UCI-Rocket-Project/rocket2-gse-hardware-old/rocket2-gse-hardware.kicad_pcb

## KiCad design rocket2-gse-hardware.kicad_pcb (2024-03-03)

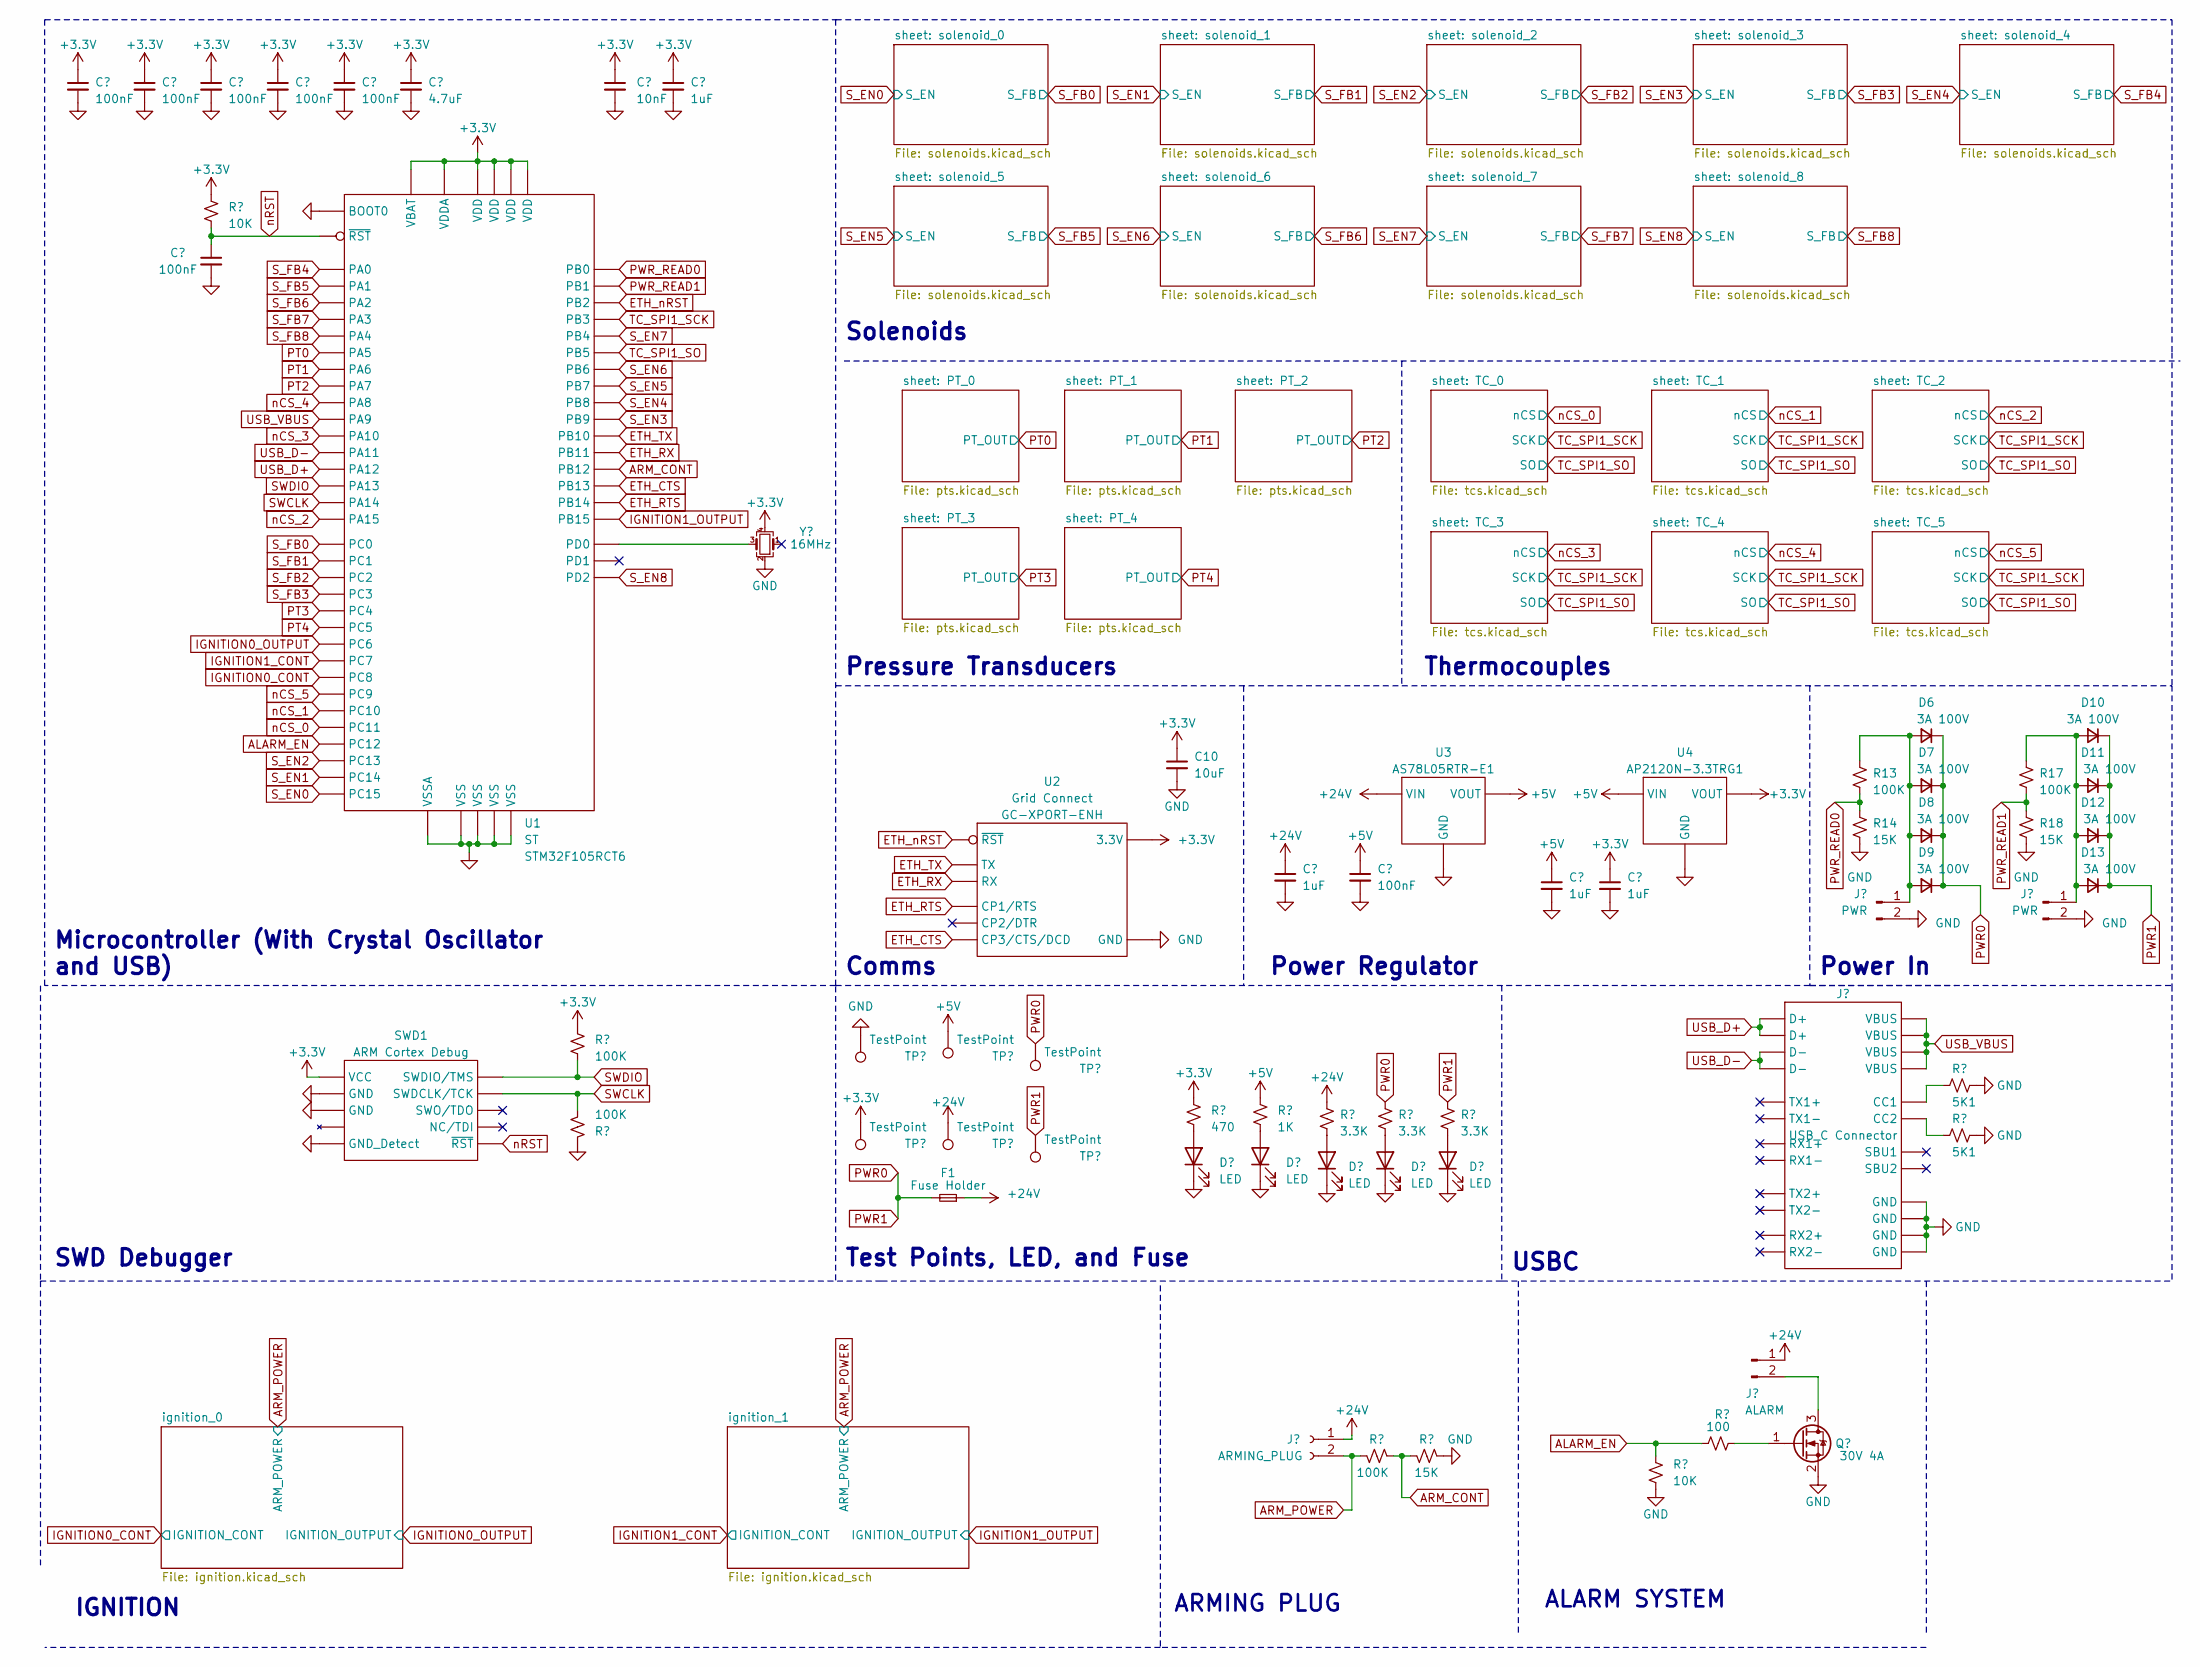
[picture p1: schematic rocket2-gse-hardware.kicad_sch]

Parts:
C1, C2, C3, C4, C5, C6, C12: 100nF; C_0402_1005Metric; Part # Generic 100nF 0402 Capacitor
C7: 4.7uF; C_0402_1005Metric; Part # Generic 4.7uF 0402 Capacitor
C8: 10nF; C_0402_1005Metric; Part # Generic 10nF 0402 Capacitor
C9, C11, C13, C14: 1uF; C_0402_1005Metric; Part # Generic 1uF 0402 Capacitor
C10: 10uF; C_0402_1005Metric; Part # Generic 10uF 0402 Capacitor
D1, D2, D3, D4, D5: LED; LED_0603_1608Metric; Part # Generic 0603 Red LED
D6, D7, D8, D9, D10, D11, D12, D13: 3A 100V; D_SMA; Part # SL310A-TP
F1: Fuse Holder; Fuseholder_Blade_Mini_Keystone_3568; Part # 3568-15
J1: ARMING_PLUG; TerminalBlock_bornier-2_P5.08mm
J2: ALARM; TerminalBlock_bornier-2_P5.08mm
J3: USB_C Connector; USB_C_Receptacle_GCT_USB4105-xx-A_16P_TopMnt_Horizontal; Part # 629105150521
J4, J5: PWR; BarrelJack_Horizontal
Q1: 30V 4A; SOT-23-3; Part # DMG3402L
R1, R11: 10K; R_0402_1005Metric; Part # Generic 10K 1% 0402 Resistor
R2, R3, R7, R13, R17: 100K; R_0402_1005Metric; Part # Generic 100K 1% 0402 Resistor
R4: 470; R_0402_1005Metric; Part # Generic 470 1% 0402 Resistor
R5: 1K; R_0402_1005Metric; Part # Generic 1K 1% 0402 Resistor
R6, R8, R10: 3.3K; R_0402_1005Metric; Part # Generic 3.3K 1% 0402 Resistor
R9, R14, R18: 15K; R_0402_1005Metric; Part # Generic 15K 1% 0402 Resistor
R12: 100; R_0402_1005Metric; Part # Generic 100 1% 0402 Resistor
R15, R16: 5K1; R_0402_1005Metric; Part # Generic 5K1 1% 0402 Resistor
SWD1: ARM Cortex Debug; PinHeader_2x05_P1.27mm_Vertical_SMD; Part # Generic 2x5 1.27mm Connector
TP1, TP2, TP3, TP4, TP5, TP6: TestPoint; TestPoint_Pad_D2.0mm
U1: LQFP-64_10x10mm_P0.5mm; Part # STM32F105RCT6
U2: GC-XPORT; Part # GC-XPORT-ENH
U3: SOT-89-3; Part # AS78L05RTR-E1
U4: SOT-23-3; Part # AP2120N-3.3TRG1
Y1: 16MHz; Crystal_SMD_2016-4Pin_2.0x1.6mm; Part # ECS-1633-160-BN-TR

Connections:
+3.3V: C1.1, C2.1, C3.1, C5.1, C6.1, C7.1, C8.1, C9.1, C10.1, C14.1, R1.1, R2.1, R4.2, SWD1.1 (VCC), TP2.1, U1.1 (VBAT), U1.13 (VDDA), U1.19 (VDD), U1.32 (VDD), U1.48 (VDD), U1.64 (VDD), U2.2 (3.3V), U4.2 (VOUT), Y1.4; also elsewhere on the board
+5V: C12.1, C13.1, R5.2, TP3.1, U3.1 (VOUT), U4.3 (VIN); also elsewhere on the board
+24V: C11.1, F1.1, J1.1, J2.1, R10.2, TP4.1, U3.3 (VIN); also elsewhere on the board
ALARM_EN: R11.1, R12.1, U1.53 (PC12)
ARM_CONT: R7.2, R9.1, U1.33 (PB12)
ARM_POWER: J1.2, R7.1; also elsewhere on the board
ETH_CTS: U1.34 (PB13), U2.8 (CP3/CTS/DCD)
ETH_RTS: U1.35 (PB14), U2.6 (CP1/RTS)
ETH_RX: U1.30 (PB11), U2.5 (RX)
ETH_TX: U1.29 (PB10), U2.4 (TX)
ETH_nRST: U1.28 (PB2), U2.3 (~RST)
GND: C1.2, C2.2, C3.2, C4.2, C5.2, C6.2, C7.2, C8.2, C9.2, C10.2, C11.2, C12.2, C13.2, C14.2, D1.1 (K), D2.1 (K), D3.1 (K), D4.1 (K), D5.1 (K), J3.A1 (GND), J3.A12 (GND), J3.B1 (GND), J3.B12 (GND), J4.2, J5.2, Q1.2 (S), R3.1, R9.2, R11.2, R14.2, R15.1, R16.1, R18.2, SWD1.3 (GND), SWD1.5 (GND), SWD1.9 (GND_Detect), TP1.1, U1.12 (VSSA), U1.18 (VSS), U1.31 (VSS), U1.47 (VSS), U1.60 (BOOT0), U1.63 (VSS), U2.1 (GND), U3.2 (GND), U4.1 (GND), Y1.2; also elsewhere on the board
IGNITION0_CONT: U1.39 (PC8); also elsewhere on the board
IGNITION0_OUTPUT: U1.37 (PC6); also elsewhere on the board
IGNITION1_CONT: U1.38 (PC7); also elsewhere on the board
IGNITION1_OUTPUT: U1.36 (PB15); also elsewhere on the board
unnamed: D1.2 (A), R4.1
unnamed: D2.2 (A), R5.1
unnamed: D3.2 (A), R10.1
unnamed: D4.2 (A), R6.1
unnamed: D5.2 (A), R8.1
unnamed: D6.2 (A), D7.2 (A), D8.2 (A), D9.2 (A), J4.1, R13.1
unnamed: D10.2 (A), D11.2 (A), D12.2 (A), D13.2 (A), J5.1, R17.1
unnamed: J2.2, Q1.3 (D)
unnamed: J3.A5 (CC1), R15.2
unnamed: J3.B5 (CC2), R16.2
unnamed: Q1.1 (G), R12.2
unnamed: U1.5 (PD0), Y1.3
PT0: U1.21 (PA5); also elsewhere on the board
PT1: U1.22 (PA6); also elsewhere on the board
PT2: U1.23 (PA7); also elsewhere on the board
PT3: U1.24 (PC4); also elsewhere on the board
PT4: U1.25 (PC5); also elsewhere on the board
PWR0: D6.1 (K), D7.1 (K), D8.1 (K), D9.1 (K), D10.1 (K), D11.1 (K), D12.1 (K), D13.1 (K), F1.2, R6.2, R8.2, TP5.1, TP6.1
PWR_READ0: R13.2, R14.1, U1.26 (PB0)
PWR_READ1: R17.2, R18.1, U1.27 (PB1)
SWCLK: R3.2, SWD1.4 (SWDCLK/TCK), U1.49 (PA14)
SWDIO: R2.2, SWD1.2 (SWDIO/TMS), U1.46 (PA13)
S_EN0: U1.4 (PC15); also elsewhere on the board
S_EN1: U1.3 (PC14); also elsewhere on the board
S_EN2: U1.2 (PC13); also elsewhere on the board
S_EN3: U1.62 (PB9); also elsewhere on the board
S_EN4: U1.61 (PB8); also elsewhere on the board
S_EN5: U1.59 (PB7); also elsewhere on the board
S_EN6: U1.58 (PB6); also elsewhere on the board
S_EN7: U1.56 (PB4); also elsewhere on the board
S_EN8: U1.54 (PD2); also elsewhere on the board
S_FB0: U1.8 (PC0); also elsewhere on the board
S_FB1: U1.9 (PC1); also elsewhere on the board
S_FB2: U1.10 (PC2); also elsewhere on the board
S_FB3: U1.11 (PC3); also elsewhere on the board
S_FB4: U1.14 (PA0); also elsewhere on the board
S_FB5: U1.15 (PA1); also elsewhere on the board
S_FB6: U1.16 (PA2); also elsewhere on the board
S_FB7: U1.17 (PA3); also elsewhere on the board
S_FB8: U1.20 (PA4); also elsewhere on the board
TC_SPI1_SCK: U1.55 (PB3); also elsewhere on the board
TC_SPI1_SO: U1.57 (PB5); also elsewhere on the board
USB_D+: J3.A6 (D+), J3.B6 (D+), U1.45 (PA12)
USB_D-: J3.A7 (D-), J3.B7 (D-), U1.44 (PA11)
USB_VBUS: J3.A4 (VBUS), J3.A9 (VBUS), J3.B4 (VBUS), J3.B9 (VBUS), U1.42 (PA9)
nCS_0: U1.52 (PC11); also elsewhere on the board
nCS_1: U1.51 (PC10); also elsewhere on the board
nCS_2: U1.50 (PA15); also elsewhere on the board
nCS_3: U1.43 (PA10); also elsewhere on the board
nCS_4: U1.41 (PA8); also elsewhere on the board
nCS_5: U1.40 (PC9); also elsewhere on the board
nRST: C4.1, R1.2, SWD1.10 (~RST), U1.7 (~RST)

Notes on the sheet:
ARMING PLUG
ALARM SYSTEM
Thermocouples
Comms
SWD Debugger
Test Points, LED, and Fuse
Pressure Transducers
Microcontroller (With Crystal Oscillator and USB)
Power In
Power Regulator
IGNITION
USBC
Solenoids

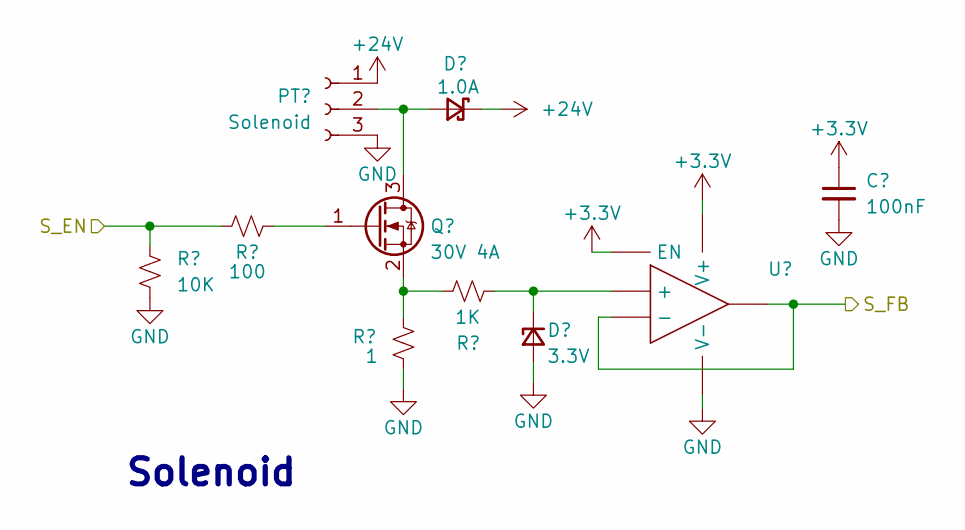
[picture p2: schematic solenoids.kicad_sch]

Parts:
C15: 100nF; C_0402_1005Metric; Part # Generic 100nF 0402 Capacitor
D14: 1.0A; D_SMA; Part # S1M
D15: 3.3V; D_SOD-123; Part # MMSZ4684T1G
Q2: 30V 4A; SOT-23-3; Part # DMG3402L
R19: 10K; R_0402_1005Metric; Part # Generic 10K 1% 0402 Resistor
R20: 100; R_0402_1005Metric; Part # Generic 100 1% 0402 Resistor
R21: 1; R_1206_3216Metric; Part # Generic 1 1% 1206 Resistor
R22: 1K; R_0402_1005Metric; Part # Generic 1K 1% 0402 Resistor
S0: Solenoid; TerminalBlock_bornier-3_P5.08mm
U5: SOT-23-6; Part # OPA357AIDBVT

Connections:
+3.3V: C15.1, U5.5 (EN), U5.6 (V+); also elsewhere on the board
+24V: D14.1 (K), S0.1; also elsewhere on the board
GND: C15.2, D15.2 (A), R19.2, R21.2, S0.3, U5.2 (V-); also elsewhere on the board
unnamed: D14.2 (A), Q2.3 (D), S0.2
unnamed: D15.1 (K), R22.2, U5.3 (+)
unnamed: Q2.1 (G), R20.2
unnamed: Q2.2 (S), R21.1, R22.1
S_EN0: R19.1, R20.1; also elsewhere on the board
S_FB0: U5.1, U5.4 (-); also elsewhere on the board

Parts of its further copies:
C16, C17, C18, C19, C20, C21, C22, C23: 100nF; C_0402_1005Metric; Part # Generic 100nF 0402 Capacitor
D16, D18, D20, D22, D24, D26, D28, D30: 1.0A; D_SMA; Part # S1M
D17, D19, D21, D23, D25, D27, D29, D31: 3.3V; D_SOD-123; Part # MMSZ4684T1G
Q3, Q4, Q5, Q6, Q7, Q8, Q9, Q10: 30V 4A; SOT-23-3; Part # DMG3402L
R23, R27, R31, R35, R39, R43, R47, R51: 10K; R_0402_1005Metric; Part # Generic 10K 1% 0402 Resistor
R24, R28, R32, R36, R40, R44, R48, R52: 100; R_0402_1005Metric; Part # Generic 100 1% 0402 Resistor
R25, R29, R33, R37, R41, R45, R49, R53: 1; R_1206_3216Metric; Part # Generic 1 1% 1206 Resistor
R26, R30, R34, R38, R42, R46, R50, R54: 1K; R_0402_1005Metric; Part # Generic 1K 1% 0402 Resistor
S1, S2, S3, S4, S5, S6, S7, S8: Solenoid; TerminalBlock_bornier-3_P5.08mm
U6, U7, U8, U9, U10, U11, U12, U13: SOT-23-6; Part # OPA357AIDBVT

Connections of its further copies:
+3.3V: C16.1, C17.1, C18.1, C19.1, C20.1, C21.1, C22.1, C23.1, U6.5 (EN), U6.6 (V+), U7.5 (EN), U7.6 (V+), U8.5 (EN), U8.6 (V+), U9.5 (EN), U9.6 (V+), U10.5 (EN), U10.6 (V+), U11.5 (EN), U11.6 (V+), U12.5 (EN), U12.6 (V+), U13.5 (EN), U13.6 (V+); also elsewhere on the board
+24V: D16.1 (K), D18.1 (K), D20.1 (K), D22.1 (K), D24.1 (K), D26.1 (K), D28.1 (K), D30.1 (K), S1.1, S2.1, S3.1, S4.1, S5.1, S6.1, S7.1, S8.1; also elsewhere on the board
GND: C16.2, C17.2, C18.2, C19.2, C20.2, C21.2, C22.2, C23.2, D17.2 (A), D19.2 (A), D21.2 (A), D23.2 (A), D25.2 (A), D27.2 (A), D29.2 (A), D31.2 (A), R23.2, R25.2, R27.2, R29.2, R31.2, R33.2, R35.2, R37.2, R39.2, R41.2, R43.2, R45.2, R47.2, R49.2, R51.2, R53.2, S1.3, S2.3, S3.3, S4.3, S5.3, S6.3, S7.3, S8.3, U6.2 (V-), U7.2 (V-), U8.2 (V-), U9.2 (V-), U10.2 (V-), U11.2 (V-), U12.2 (V-), U13.2 (V-); also elsewhere on the board
unnamed: D16.2 (A), Q3.3 (D), S1.2
unnamed: D17.1 (K), R26.2, U6.3 (+)
unnamed: D18.2 (A), Q4.3 (D), S2.2
unnamed: D19.1 (K), R30.2, U7.3 (+)
unnamed: D20.2 (A), Q5.3 (D), S3.2
unnamed: D21.1 (K), R34.2, U8.3 (+)
unnamed: D22.2 (A), Q6.3 (D), S4.2
unnamed: D23.1 (K), R38.2, U9.3 (+)
unnamed: D24.2 (A), Q7.3 (D), S5.2
unnamed: D25.1 (K), R42.2, U10.3 (+)
unnamed: D26.2 (A), Q8.3 (D), S6.2
unnamed: D27.1 (K), R46.2, U11.3 (+)
unnamed: D28.2 (A), Q9.3 (D), S7.2
unnamed: D29.1 (K), R50.2, U12.3 (+)
unnamed: D30.2 (A), Q10.3 (D), S8.2
unnamed: D31.1 (K), R54.2, U13.3 (+)
unnamed: Q3.1 (G), R24.2
unnamed: Q3.2 (S), R25.1, R26.1
unnamed: Q4.1 (G), R28.2
unnamed: Q4.2 (S), R29.1, R30.1
unnamed: Q5.1 (G), R32.2
unnamed: Q5.2 (S), R33.1, R34.1
unnamed: Q6.1 (G), R36.2
unnamed: Q6.2 (S), R37.1, R38.1
unnamed: Q7.1 (G), R40.2
unnamed: Q7.2 (S), R41.1, R42.1
unnamed: Q8.1 (G), R44.2
unnamed: Q8.2 (S), R45.1, R46.1
unnamed: Q9.1 (G), R48.2
unnamed: Q9.2 (S), R49.1, R50.1
unnamed: Q10.1 (G), R52.2
unnamed: Q10.2 (S), R53.1, R54.1
S_EN1: R23.1, R24.1; also elsewhere on the board
S_EN2: R27.1, R28.1; also elsewhere on the board
S_EN3: R31.1, R32.1; also elsewhere on the board
S_EN4: R35.1, R36.1; also elsewhere on the board
S_EN5: R39.1, R40.1; also elsewhere on the board
S_EN6: R43.1, R44.1; also elsewhere on the board
S_EN7: R47.1, R48.1; also elsewhere on the board
S_EN8: R51.1, R52.1; also elsewhere on the board
S_FB1: U6.1, U6.4 (-); also elsewhere on the board
S_FB2: U7.1, U7.4 (-); also elsewhere on the board
S_FB3: U8.1, U8.4 (-); also elsewhere on the board
S_FB4: U9.1, U9.4 (-); also elsewhere on the board
S_FB5: U10.1, U10.4 (-); also elsewhere on the board
S_FB6: U11.1, U11.4 (-); also elsewhere on the board
S_FB7: U12.1, U12.4 (-); also elsewhere on the board
S_FB8: U13.1, U13.4 (-); also elsewhere on the board

Notes on the sheet:
Solenoid

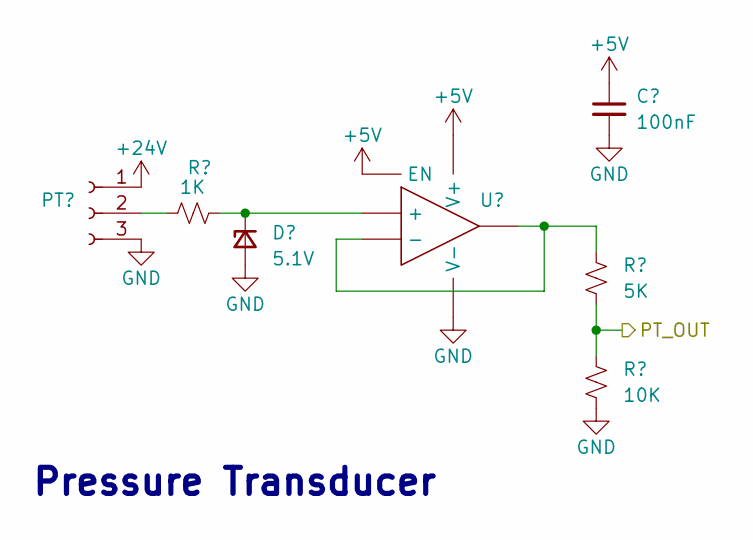
[picture p3: schematic pts.kicad_sch]

Parts:
C27: 100nF; C_0402_1005Metric; Part # Generic 100nF 0402 Capacitor
D35: 5.1V; D_MiniMELF; Part # BZV55-B5V1,115
PT2: Pressure Transducer 1; TerminalBlock_bornier-3_P5.08mm
R64: 1K; R_0402_1005Metric; Part # Generic 1K 1% 0402 Resistor
R65: 5K; R_0402_1005Metric; Part # Generic 5K 1% 0402 Resistor
R66: 10K; R_0402_1005Metric; Part # Generic 10K 1% 0402 Resistor
U17: SOT-23-6; Part # OPA357AIDBVT

Connections:
+5V: C27.1, U17.5 (EN), U17.6 (V+); also elsewhere on the board
+24V: PT2.1; also elsewhere on the board
GND: C27.2, D35.2 (A), PT2.3, R66.2, U17.2 (V-); also elsewhere on the board
unnamed: D35.1 (K), R64.2, U17.3 (+)
unnamed: PT2.2, R64.1
unnamed: R65.1, U17.1, U17.4 (-)
PT2: R65.2, R66.1; also elsewhere on the board

Parts of its further copies:
C24, C25, C26, C28: 100nF; C_0402_1005Metric; Part # Generic 100nF 0402 Capacitor
D32, D33, D34, D36: 5.1V; D_MiniMELF; Part # BZV55-B5V1,115
PT0, PT1, PT3, PT4: Pressure Transducer 1; TerminalBlock_bornier-3_P5.08mm
R55, R58, R61, R67: 1K; R_0402_1005Metric; Part # Generic 1K 1% 0402 Resistor
R56, R59, R62, R68: 5K; R_0402_1005Metric; Part # Generic 5K 1% 0402 Resistor
R57, R60, R63, R69: 10K; R_0402_1005Metric; Part # Generic 10K 1% 0402 Resistor
U14, U15, U16, U18: SOT-23-6; Part # OPA357AIDBVT

Connections of its further copies:
+5V: C24.1, C25.1, C26.1, C28.1, U14.5 (EN), U14.6 (V+), U15.5 (EN), U15.6 (V+), U16.5 (EN), U16.6 (V+), U18.5 (EN), U18.6 (V+); also elsewhere on the board
+24V: PT0.1, PT1.1, PT3.1, PT4.1; also elsewhere on the board
GND: C24.2, C25.2, C26.2, C28.2, D32.2 (A), D33.2 (A), D34.2 (A), D36.2 (A), PT0.3, PT1.3, PT3.3, PT4.3, R57.2, R60.2, R63.2, R69.2, U14.2 (V-), U15.2 (V-), U16.2 (V-), U18.2 (V-); also elsewhere on the board
unnamed: D32.1 (K), R55.2, U14.3 (+)
unnamed: D33.1 (K), R58.2, U15.3 (+)
unnamed: D34.1 (K), R61.2, U16.3 (+)
unnamed: D36.1 (K), R67.2, U18.3 (+)
unnamed: PT0.2, R61.1
unnamed: PT1.2, R58.1
unnamed: PT3.2, R67.1
unnamed: PT4.2, R55.1
unnamed: R56.1, U14.1, U14.4 (-)
unnamed: R59.1, U15.1, U15.4 (-)
unnamed: R62.1, U16.1, U16.4 (-)
unnamed: R68.1, U18.1, U18.4 (-)
PT0: R62.2, R63.1; also elsewhere on the board
PT1: R59.2, R60.1; also elsewhere on the board
PT3: R68.2, R69.1; also elsewhere on the board
PT4: R56.2, R57.1; also elsewhere on the board

Notes on the sheet:
Pressure Transducer

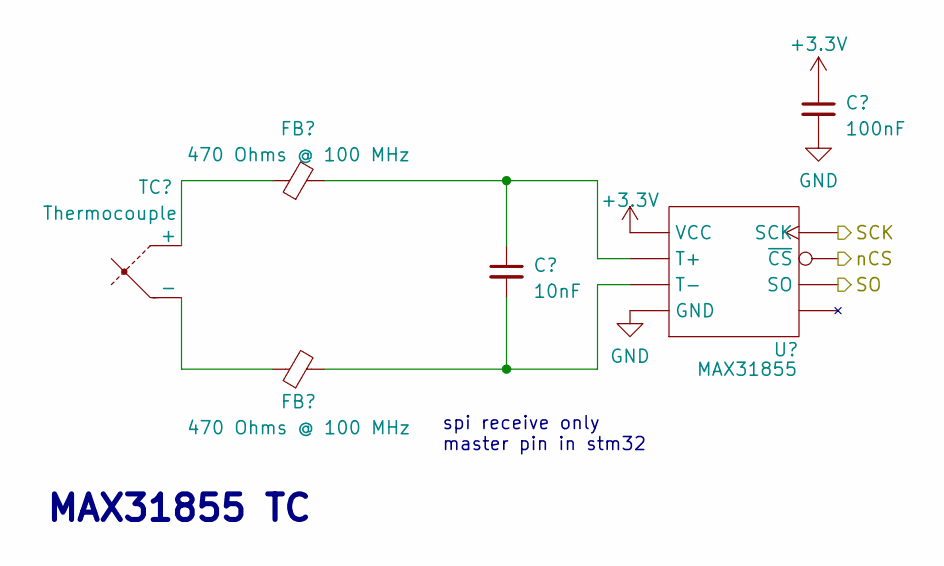
[picture p4: schematic tcs.kicad_sch]

Parts:
C39: 10nF; C_0402_1005Metric; Part # Generic 10nF 0402 Capacitor
C40: 100nF; C_0402_1005Metric; Part # Generic 100nF 0402 Capacitor
FB11, FB12: 470 Ohms @ 100 MHz; L_0603_1608Metric; Part # BLM18PG471SH1D
TC5: Thermocouple; AM-K-PCB; Part # AM-K-PCB
U24: SOIC-8_3.9x4.9mm_P1.27mm; Part # MAX31855

Connections:
+3.3V: C40.1, U24.4 (VCC); also elsewhere on the board
GND: C40.2, U24.1 (GND); also elsewhere on the board
unnamed: FB11.1, TC5.1 (+)
unnamed: FB12.1, TC5.2 (-)
unnamed: C39.1, FB11.2, U24.3 (T+)
unnamed: C39.2, FB12.2, U24.2 (T-)
TC_SPI1_SCK: U24.5 (SCK); also elsewhere on the board
TC_SPI1_SO: U24.7 (SO); also elsewhere on the board
nCS_5: U24.6 (~CS); also elsewhere on the board

Parts of its further copies:
C29, C31, C33, C35, C37: 10nF; C_0402_1005Metric; Part # Generic 10nF 0402 Capacitor
C30, C32, C34, C36, C38: 100nF; C_0402_1005Metric; Part # Generic 100nF 0402 Capacitor
FB1, FB2, FB3, FB4, FB5, FB6, FB7, FB8, FB9, FB10: 470 Ohms @ 100 MHz; L_0603_1608Metric; Part # BLM18PG471SH1D
TC0, TC1, TC2, TC3, TC4: Thermocouple; AM-K-PCB; Part # AM-K-PCB
U19, U20, U21, U22, U23: SOIC-8_3.9x4.9mm_P1.27mm; Part # MAX31855

Connections of its further copies:
+3.3V: C30.1, C32.1, C34.1, C36.1, C38.1, U19.4 (VCC), U20.4 (VCC), U21.4 (VCC), U22.4 (VCC), U23.4 (VCC); also elsewhere on the board
GND: C30.2, C32.2, C34.2, C36.2, C38.2, U19.1 (GND), U20.1 (GND), U21.1 (GND), U22.1 (GND), U23.1 (GND); also elsewhere on the board
unnamed: FB3.1, TC0.1 (+)
unnamed: FB4.1, TC0.2 (-)
unnamed: FB1.1, TC1.1 (+)
unnamed: FB2.1, TC1.2 (-)
unnamed: FB5.1, TC2.1 (+)
unnamed: FB6.1, TC2.2 (-)
unnamed: FB7.1, TC3.1 (+)
unnamed: FB8.1, TC3.2 (-)
unnamed: FB9.1, TC4.1 (+)
unnamed: FB10.1, TC4.2 (-)
unnamed: C29.1, FB1.2, U19.3 (T+)
unnamed: C29.2, FB2.2, U19.2 (T-)
unnamed: C31.1, FB3.2, U20.3 (T+)
unnamed: C31.2, FB4.2, U20.2 (T-)
unnamed: C33.1, FB5.2, U21.3 (T+)
unnamed: C33.2, FB6.2, U21.2 (T-)
unnamed: C35.1, FB7.2, U22.3 (T+)
unnamed: C35.2, FB8.2, U22.2 (T-)
unnamed: C37.1, FB9.2, U23.3 (T+)
unnamed: C37.2, FB10.2, U23.2 (T-)
TC_SPI1_SCK: U19.5 (SCK), U20.5 (SCK), U21.5 (SCK), U22.5 (SCK), U23.5 (SCK); also elsewhere on the board
TC_SPI1_SO: U19.7 (SO), U20.7 (SO), U21.7 (SO), U22.7 (SO), U23.7 (SO); also elsewhere on the board
nCS_0: U20.6 (~CS); also elsewhere on the board
nCS_1: U19.6 (~CS); also elsewhere on the board
nCS_2: U21.6 (~CS); also elsewhere on the board
nCS_3: U22.6 (~CS); also elsewhere on the board
nCS_4: U23.6 (~CS); also elsewhere on the board

Notes on the sheet:
spi receive only master pin in stm32
MAX31855 TC

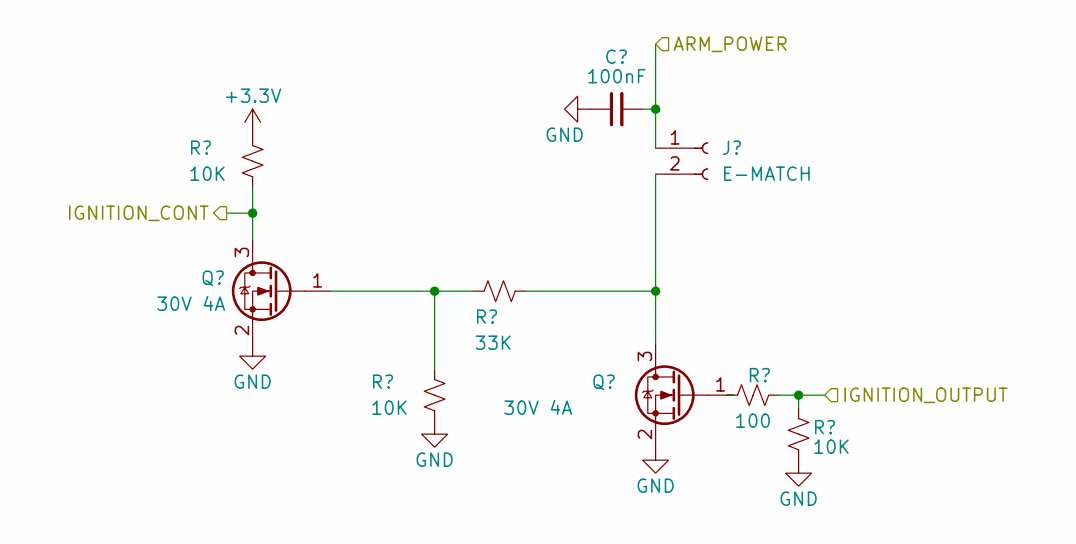
[picture p5: schematic ignition.kicad_sch]

Parts:
C42: 100nF; C_0402_1005Metric; Part # Generic 100nF 0402 Capacitor
J7: E-MATCH; TerminalBlock_bornier-2_P5.08mm
Q13, Q14: 30V 4A; SOT-23-3; Part # DMG3402L
R75, R76, R79: 10K; R_0402_1005Metric; Part # Generic 10K 1% 0402 Resistor
R77: 33K; R_0402_1005Metric; Part # Generic 33K 1% 0402 Resistor
R78: 100; R_0402_1005Metric; Part # Generic 100 1% 0402 Resistor

Connections:
+3.3V: R75.1; also elsewhere on the board
ARM_POWER: C42.2, J7.1; also elsewhere on the board
GND: C42.1, Q13.2 (S), Q14.2 (S), R76.2, R79.2; also elsewhere on the board
IGNITION0_CONT: Q13.3 (D), R75.2; also elsewhere on the board
IGNITION0_OUTPUT: R78.2, R79.1; also elsewhere on the board
unnamed: J7.2, Q14.3 (D), R77.1
unnamed: Q13.1 (G), R76.1, R77.2
unnamed: Q14.1 (G), R78.1

Parts of its further copies:
C41: 100nF; C_0402_1005Metric; Part # Generic 100nF 0402 Capacitor
J6: E-MATCH; TerminalBlock_bornier-2_P5.08mm
Q11, Q12: 30V 4A; SOT-23-3; Part # DMG3402L
R70, R71, R74: 10K; R_0402_1005Metric; Part # Generic 10K 1% 0402 Resistor
R72: 33K; R_0402_1005Metric; Part # Generic 33K 1% 0402 Resistor
R73: 100; R_0402_1005Metric; Part # Generic 100 1% 0402 Resistor

Connections of its further copies:
+3.3V: R70.1; also elsewhere on the board
ARM_POWER: C41.2, J6.1; also elsewhere on the board
GND: C41.1, Q11.2 (S), Q12.2 (S), R71.2, R74.2; also elsewhere on the board
IGNITION1_CONT: Q11.3 (D), R70.2; also elsewhere on the board
IGNITION1_OUTPUT: R73.2, R74.1; also elsewhere on the board
unnamed: J6.2, Q12.3 (D), R72.1
unnamed: Q11.1 (G), R71.1, R72.2
unnamed: Q12.1 (G), R73.1

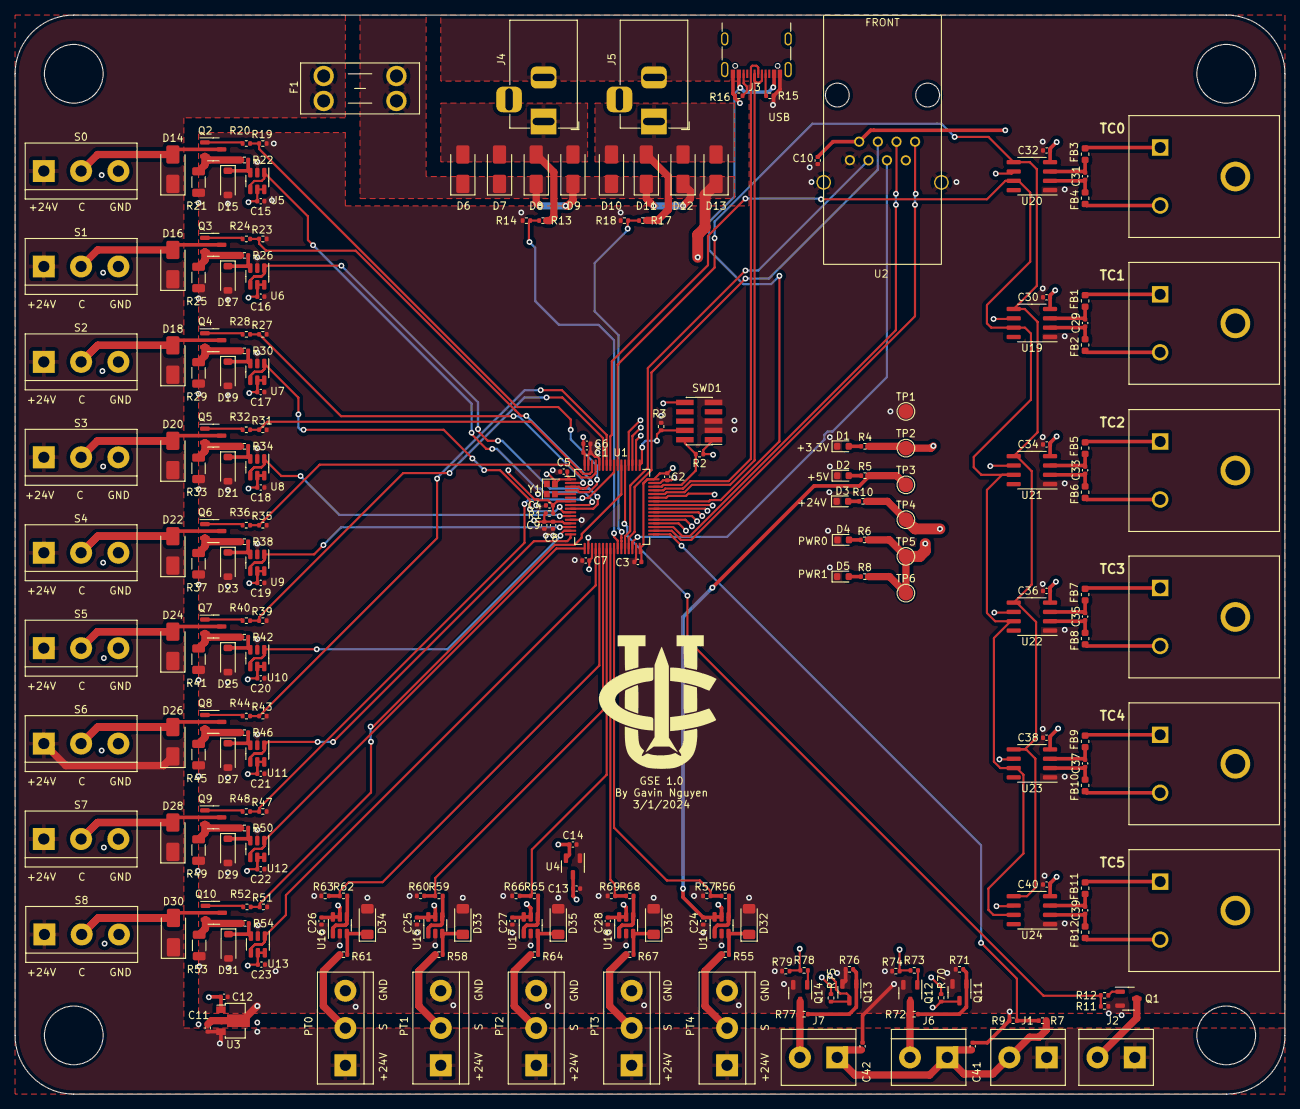
[picture p6: board rocket2-gse-hardware.kicad_pcb from above]

Board: 4 copper layers, 173.0 x 147.0 mm, 243 parts (0 on the bottom side), 149 nets.
