UCI-Rocket-Project/rocket2-gse-hardware-old/(commit log)

2024-02-09 added schematic and usbc
    [pts.kicad_sch, rocket2-gse-hardware.kicad_pcb, rocket2-gse-hardware.kicad_sch, solenoids.kicad_sch, tcs.kicad_sch, template.kicad_pcb, template.kicad_sch]
2024-02-10 fixed resistor values
    [pts.kicad_sch, rocket2-gse-hardware.kicad_sch, solenoids.kicad_sch, tcs.kicad_sch]
2024-02-25 added full schematic and outdated pcb
    [pts.kicad_sch, rocket2-gse-hardware.kicad_pcb, rocket2-gse-hardware.kicad_sch, solenoids.kicad_sch, tcs.kicad_sch]
2024-02-26 final polished schematic b4 daniel fixes nmosfet and ignition circuit
    [ignition.kicad_sch, pts.kicad_sch, rocket2-gse-hardware.kicad_sch, solenoids.kicad_sch, tcs.kicad_sch]
2024-02-28 Added in dual power, fuse, status led, and comments
    [ignition.kicad_sch, pts.kicad_sch, rocket2-gse-hardware.kicad_sch, solenoids.kicad_sch, tcs.kicad_sch]
2024-02-28 storing old schematic in commit before pulling
    [rocket2-gse-hardware.kicad_sch]
2024-03-02 finished pcb design of gse 1.0
    [ignition.kicad_sch, pts.kicad_sch, rocket2-gse-hardware.kicad_pcb, rocket2-gse-hardware.kicad_sch, solenoids.kicad_sch, tcs.kicad_sch]
2024-03-02 removed some thermal errors
    [rocket2-gse-hardware.kicad_pcb]
2024-03-02 Fix planes
    [rocket2-gse-hardware.kicad_pcb]
2024-03-03 fixed planes
    [rocket2-gse-hardware.kicad_pcb]
2024-03-03 finished power planes
